adamfowleruk/herald-hardware/wearable-v2/housing/eHealthMakersKit.FCStd

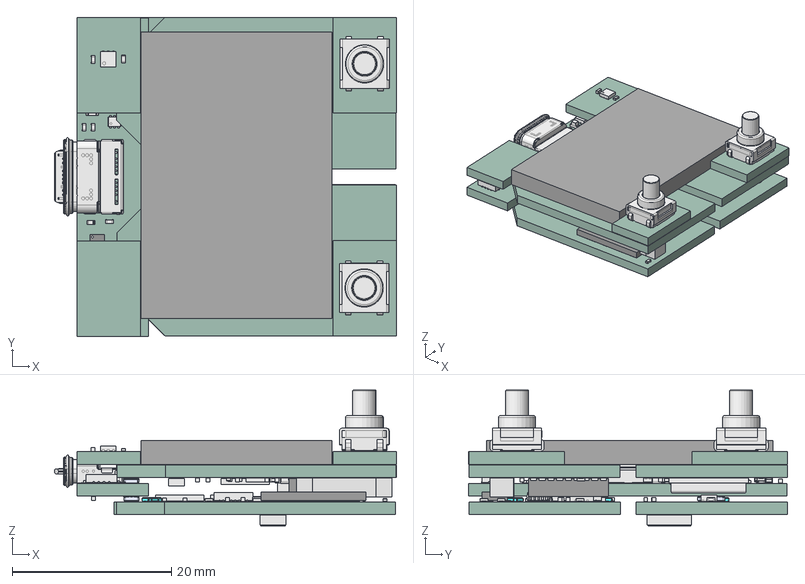
[picture p1: CAD file, 2023-11-01]
wearable-v2/housing/eHealthMakersKit.FCStd
43.0 x 40.1 x 17.1 mm
_autosave-wearable-v2 PCB3
_autosave-wearable-v2 PCB6
_autosave-wearable-v2 PCB7
_autosave-wearable-v2 PCB2
_autosave-wearable-v2 PCB4
_autosave-wearable-v2 PCB1
_autosave-wearable-v2 PCB9
_autosave-wearable-v2 PCB8
_autosave-wearable-v2 PCB5
