adamfowleruk/herald-hardware/wearable-v2/pcb-expansion-positioning/pcb-expansion-positioning.step

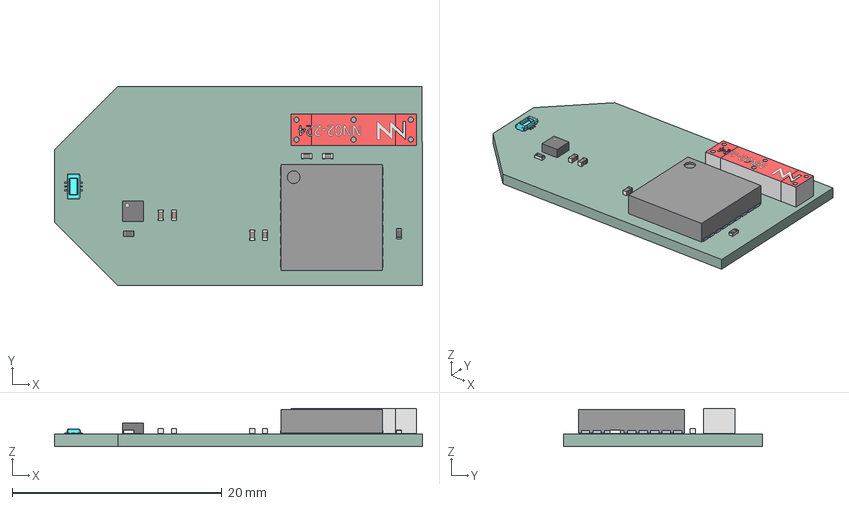
[picture p2: CAD file, 2023-11-05]
wearable-v2/pcb-expansion-positioning/pcb-expansion-positioning.step
35.1 x 19.0 x 3.64 mm
pcb-expansion-positioning PCB
