adamfowleruk/herald-hardware/wearable-v2/pcb-expansion-positioning/pcb-expansion-positioning.kicad_pcb

## KiCad design wearable-v2/pcb-expansion-positioning/pcb-expansion-positioning.kicad_pcb (2023-11-13)

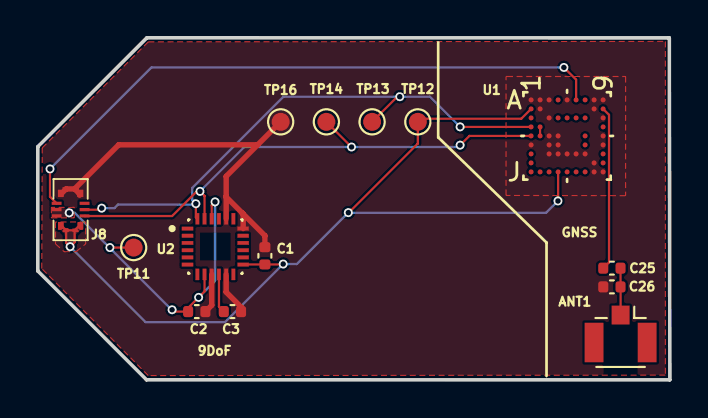
[picture p3: board pcb-expansion-positioning.kicad_pcb from above]

Board: 2 copper layers, 35.1 x 19.0 mm, 14 parts (0 on the bottom side), 10 nets.

Parts:
ANT1: U.FL_Hirose_U.FL-R-SMT-1_Vertical
C1, C2, C3: 100nF; C_0402_1005Metric
C25: 120pF; C_0402_1005Metric
C26: Tune (~120pF); C_0402_1005Metric
J8: HERALD_V2_CONN_PLUG; HERALD_V2_CONN_PORT
TP11: VDD1; TestPoint_Pad_D1.0mm
TP12: VDD; TestPoint_Pad_D1.0mm
TP13: SDA; TestPoint_Pad_D1.0mm
TP14: SCL; TestPoint_Pad_D1.0mm
TP16: GND; TestPoint_Pad_D1.0mm
U1: MIA-M10Q-00B; LGA_M10Q-00B_UBL
U2: ICM-20948; ICM-20948-QFN40P300X300X105-24N

Connections:
/Positioning Board V1/ANT_RF: C25.1, U1.B9 (RF_IN)
/Positioning Board V1/GNSS_INT: J8.6 (INT), U1.A6 (EXTINT)
/Positioning Board V1/SCL: J8.3 (SCL), TP14.1, U1.E1 (SCL), U2.23 (SCL/SCLK)
/Positioning Board V1/SDA: J8.5 (SDA), TP13.1, U1.D1 (SDA), U2.24 (SDA/SDI)
GND: C1.2, C2.1, C3.1, C26.2, J8.8 (GND), TP16.1, U1.A1 (GND), U1.A2 (GND), U1.A3 (GND), U1.A5 (RTC_O), U1.A8 (GND), U1.A9 (GND), U1.B2 (GND), U1.B8 (GND), U1.C3 (GND), U1.C9 (GND), U1.E3 (GND), U1.E4 (GND), U1.E9 (GND), U1.F1 (GND), U1.F3 (GND), U1.F4 (GND), U1.F9 (RESERVED), U1.G3 (GND), U1.G4 (GND), U1.G5 (GND), U1.G6 (GND), U1.G7 (RESERVED), U1.H8 (GND), U1.J8 (GND), U1.J9 (GND), U2.9 (AD0/SDO), U2.11 (FSYNC), U2.18 (GND), U2.20 (RESV_20)
unnamed: ANT1.1, C25.2, C26.1
unnamed: U1.D2 (RESERVED), U1.E2 (RESERVED)
unnamed: C3.2, U2.10 (REGOUT)
VDD: C1.1, J8.1 (3V3), TP12.1, U1.B1 (VCC), U1.J4 (V_IO), U2.13 (VDD)
VDD1: C2.2, J8.2 (1V8), J8.4 (1V8), TP11.1, U2.8 (VDDIO), U2.22 (~CS)
