adamfowleruk/herald-hardware/wearable-v2/pcb-connector-micro/pcb-connector-micro.kicad_pcb

## KiCad design wearable-v2/pcb-connector-micro/pcb-connector-micro.kicad_pcb (2023-11-13)

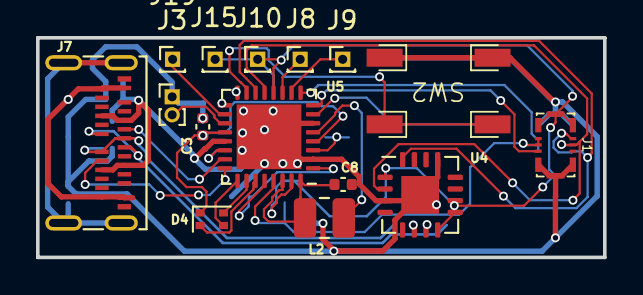
[picture p4: board pcb-connector-micro.kicad_pcb from above]

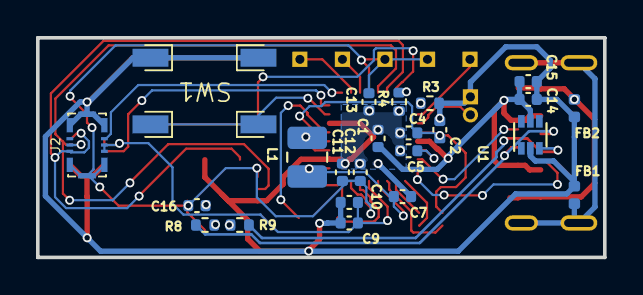
[picture p5: board pcb-connector-micro.kicad_pcb from below]

Board: 2 copper layers, 31.5 x 12.2 mm, 38 parts (23 on the bottom side), 33 nets.

Parts:
C1, C5: 1uF; C_0402_1005Metric
C2, C3, C4, C7, C8, C9, C10, C11, C12: 10uF; C_0402_1005Metric
C13, C16: 100nF; C_0402_1005Metric
C14: 4.7uF; C_0402_1005Metric
C15: 100nF/100V; C_0402_1005Metric
D4: LED_ARGY; LED_Kingbright_APHF1608
FB1, FB2: 120R/0.6A; L_0402_1005Metric
J1, J2: HERALD_V2_CONN_RECEPTACLE
J3, J8, J9, J10, J15: Conn_01x01_Pin; PinHeader_1x01_P1.00mm_Vertical
J7: USB_C_Receptacle_USB2.0; USB_C_Receptacle_IPxx
J19: Conn_01x02_Pin; PinHeader_1x02_P1.00mm_Vertical
L1, L2: 2.2uH; L_1008_2520Metric
R3: 4.7K; R_0402_1005Metric
R4: 499K; R_0402_1005Metric
R8, R9: 27; R_0402_1005Metric
SW1, SW2: PTS526
U1: DT1446-04V; SOT-563
U4: FT201XQ; QFN-16-1EP_4x4mm_P0.65mm_EP2.1x2.1mm
U5: nPM1300-QEAA; QFN-32-1EP_5x5mm_P0.5mm_EP3.6x3.6mm

Connections:
/Micro Connector/+BATT: J19.2, U5.19 (VBAT)
/Micro Connector/CC1: J7.A5 (CC1), U5.23 (CC1)
/Micro Connector/CC2: J7.B5 (CC2), U5.24 (CC2)
/Micro Connector/GPIO_1: J9.1, U5.10 (GPIO3)
/Micro Connector/GPIO_2: J8.1, U5.11 (GPIO4)
/Micro Connector/I3C_SCL: J1.3 (SCL), J2.3 (SCL), U4.16 (SCL), U5.14 (SCL)
/Micro Connector/I3C_SDA: J1.5 (SDA), J2.5 (SDA), U4.2 (SDA), U5.13 (SDA)
/Micro Connector/INT_1: J1.6 (INT), U5.8 (GPIO1)
/Micro Connector/INT_2: J2.6 (INT), U5.9 (GPIO2)
/Micro Connector/LED_PWR_G: D4.3 (GK), U5.25 (LED0)
/Micro Connector/LED_PWR_R: D4.2 (RK), U5.27 (LED2)
/Micro Connector/LED_PWR_Y: D4.4 (BK), U5.26 (LED1)
/Micro Connector/NTC: J3.1, U5.18 (NTC)
/Micro Connector/RST_CONN: SW1.1, SW1.2, U5.7 (GPIO0)
/Micro Connector/USB_D+: J7.A6 (D+), J7.B6 (D+), R9.1, U1.3
/Micro Connector/USB_D-: J7.A7 (D-), J7.B7 (D-), R8.2, U1.1
/Micro Connector/VBUSOUT: C5.1, U5.22 (VBUSOUT)
/Micro Connector/VCC_1V8: C9.1, C10.1, J1.2 (1V8), J1.4 (1V8), J2.2 (1V8), J2.4 (1V8), U5.29 (VOUTLDO1)
/Micro Connector/VOUT1: C7.1, L1.1, U5.1 (VOUT1), U5.28 (VINLDO1)
/Micro Connector/VOUT2: C8.1, L2.1, U5.30 (VINLDO2), U5.32 (VOUT2)
/Micro Connector/VSYS: C2.1, C3.1, C4.1, D4.1 (A), U5.4 (PVDD), U5.20 (VSYS)
Earth: FB1.1, J7.S1 (SHIELD)
GND: C1.2, C2.2, C3.2, C4.2, C5.2, C7.2, C8.2, C9.2, C10.2, C11.2, C12.2, C13.1, C14.1, C15.1, C16.2, FB1.2, FB2.2, J1.8 (GND), J2.8 (GND), J19.1, R3.2, R4.1, SW1.3, SW1.4, SW2.3, SW2.4, U1.2, U4.3 (GND), U4.13 (GND), U4.17 (GND), U5.2 (PVSS1), U5.6 (PVSS2), U5.33 (AVS)
GNDPWR: FB2.1, J7.A1 (GND), J7.A12 (GND), J7.B1 (GND), J7.B12 (GND)
unnamed: R8.1, U4.7 (USBDM)
unnamed: R9.2, U4.6 (USBDP)
unnamed: SW2.1, SW2.2, U5.15 (SHPHLD)
unnamed: L1.2, U5.3 (SW1)
unnamed: L2.2, U5.5 (SW2)
unnamed: R3.1, U5.17 (VSET1)
unnamed: R4.2, U5.16 (VSET2)
VBUS: C1.1, C14.2, C15.2, J7.A4 (VBUS), J7.A9 (VBUS), J7.B4 (VBUS), J7.B9 (VBUS), U1.5, U5.21 (VBUS)
VDD: C11.1, C12.1, C13.2, C16.1, J1.1 (3V3), J2.1 (3V3), J10.1, J15.1, U4.1 (VCCIO), U4.8 (3V3OUT), U4.9 (~RESET), U4.10 (VCC), U5.12 (VDDIO), U5.31 (VOUTLDO2)
