adamfowleruk/herald-hardware/wearable-v2/pcb-expansion-feedback/pcb-expansion-feedback.kicad_pcb

## KiCad design wearable-v2/pcb-expansion-feedback/pcb-expansion-feedback.kicad_pcb (2023-11-11)

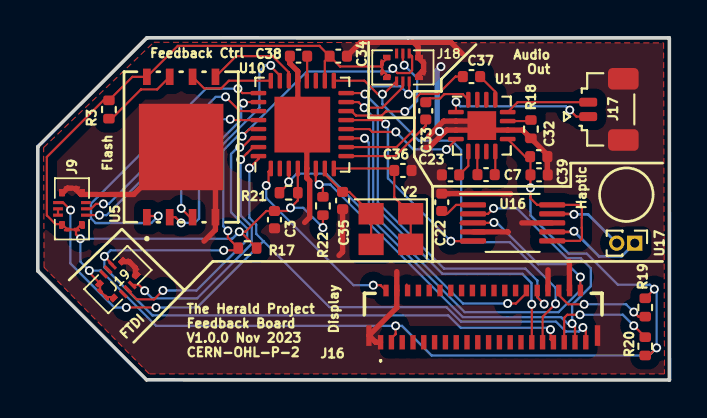
[picture p6: board pcb-expansion-feedback.kicad_pcb from above]

Board: 2 copper layers, 35.1 x 19.0 mm, 31 parts (0 on the bottom side), 43 nets.

Parts:
BoardFeedback: Board Feedback; Board
C3, C38, C39: 100nF 0402; C_0402_1005Metric
C7, C22, C23, C32: 1uF 0402; C_0402_1005Metric
C33, C37: 2.2uF 0402; C_0402_1005Metric
C34: 10uF 0402; C_0402_1005Metric
C35, C36: 22pF 0402; C_0402_1005Metric
J9, J19: HERALD_V2_CONN_PLUG; HERALD_V2_CONN_PORT
J16: EA_WF030-39S; EAWF03039S
J17: JST_AUDIO_OUT; JST_SUR_SM02B-SURS-TF_1x02-1MP_P0.80mm_Horizontal
J18: HERALD_V2_CONN_PLUG_ARMSWD; HERALD_V2_CONN_PORT
R3: 10k; R_0402_1005Metric
R17, R21, R22: 1k 0402; R_0402_1005Metric
R18: 49.9k 0402; R_0402_1005Metric
R19, R20: 10k 0402; R_0402_1005Metric
U5: MX25R6435FZNIL0; 8-WSON_MAC
U10: ATmega328PB-M; QFN-32-1EP_5x5mm_P0.5mm_EP3.1x3.1mm
U13: TPA6139A2RGTR; TQFN-16-1EP_3x3mm_P0.5mm_EP1.6x1.6mm
U16: DRV2605LDGSR; VSSOP-10_3x3mm_P0.5mm
U17: VG0832013D; PinHeader_1x02_P1.00mm_Vertical
Y2: 8Mhz; Crystal_SMD_3225-4Pin_3.2x2.5mm

Connections:
/ Display Board V1/DISP_CSX: J16.28, U10.11 (PD7)
/ Display Board V1/DISP_DCX: J16.31, J18.3 (SCL), U10.17 (PB5)
/ Display Board V1/DISP_IM1+IM2: J16.34, R19.2
/ Display Board V1/DISP_IM3: J16.35, R20.2
/ Display Board V1/DISP_SDA: J16.29, J18.5 (SDA), U10.15 (PB3)
/ Display Board V1/DISP_SDO: J16.30, J18.7 (SDO), U10.16 (PB4)
/ Display Board V1/FB_AUDIO_PWM_LEFT: C33.2, U10.9 (PD5)
/ Display Board V1/FB_AUDIO_PWM_RIGHT: C37.1, U10.10 (PD6)
/ Display Board V1/FB_AUDIO_SEL: U10.12 (PB0), U13.4 (MUTE)
/ Display Board V1/FB_AVR_RESET: J16.33, J18.6 (RST), J19.6 (INT), R17.1, U10.29 (~RESET/PC6)
/ Display Board V1/FB_FLASH_RST: R3.2, U5.7 (~RESET/SIO3)
/ Display Board V1/FB_FLASH_SEL: U5.1 (~CS), U10.25 (PC2)
/ Display Board V1/FB_FLASH_WP: U5.3 (~WP/SIO2), U10.26 (PC3)
/ Display Board V1/FB_INT: J9.6 (INT), J16.39, U10.32 (PD2)
/ Display Board V1/FB_LED_PWM: J16.2, U10.1 (PD3)
/ Display Board V1/FB_LRA+: U16.7 (OUT+), U17.1 (LRA+)
/ Display Board V1/FB_LRA-: U16.9 (OUT-), U17.2 (LRA-)
/ Display Board V1/FB_MISO1: U5.2 (SO/SIO1), U10.23 (PC0)
/ Display Board V1/FB_MOSI1: U5.5 (SI/SIO0), U10.22 (PE3)
/ Display Board V1/FB_SCK1: U5.6 (SCLK), U10.24 (PC1)
/ Display Board V1/FB_SCL: J16.37, R22.2, U10.6 (PE1), U16.2 (SCL)
/ Display Board V1/FB_SDA: J16.38, R21.2, U10.3 (PE0), U16.3 (SDA)
/ Display Board V1/FB_SPEAKER_OUT_LEFT: J17.1, U13.1 (OUT_L)
/ Display Board V1/FB_SPEAKER_OUT_RIGHT: J17.2, U13.12 (OUT_R)
/ Display Board V1/FB_SS0: J18.4 (SEL), U10.14 (PB2)
/ Display Board V1/FB_TWI_RX: J19.5 (SDA), U10.30 (PD0)
/ Display Board V1/FB_TWI_TX: J19.7 (GPIO), U10.31 (PD1)
/ Display Board V1/FB_VIBRATE_EN: U10.13 (PB1), U16.5 (EN)
/ Display Board V1/I3C_SCL: J9.3 (SCL), U10.28 (PC5)
/ Display Board V1/I3C_SDA: J9.5 (SDA), U10.27 (PC4)
/ Display Board V1/VCC_1V8: J9.2 (1V8), J9.4 (1V8)
GND: C3.1, C22.1, C23.2, C32.2, C34.2, C35.1, C36.1, C38.1, C39.2, J9.8 (GND), J16.1, J16.4, J16.32, J16.36, J16.MP1, J16.MP2, J17.MP, J18.8 (GND), J19.8 (GND), R18.2, U5.4 (GND), U5.9, U10.5 (GND), U10.21 (GND), U10.33 (GND), U13.2 (GND), U13.3 (GND), U13.10 (GND), U13.17 (GND), U16.4 (IN/TRIG), U16.8 (GND)
unnamed: C38.2, U10.20 (AREF)
unnamed: C35.2, U10.7 (XTAL1/PB6), Y2.2, Y2.3
unnamed: C36.2, U10.8 (XTAL2/PB7), Y2.1, Y2.4
unnamed: C7.2, U13.6 (CN)
unnamed: C7.1, U13.8 (CP)
unnamed: R18.1, U13.11 (GAIN)
unnamed: C33.1, U13.16 (IN_L)
unnamed: C37.2, U13.13 (IN_R)
unnamed: C23.1, U13.5 (VSS)
unnamed: C22.2, U16.1 (REG)
VDD: C3.2, C32.1, C34.1, C39.1, J9.1 (3V3), J16.3, J18.1 (3V3), J19.1 (3V3), R3.1, R17.2, R19.1, R20.1, R21.1, R22.1, U5.8 (VCC), U10.4 (VCC), U10.18 (AVCC), U13.9 (VDD), U16.6 (VDD/NC), U16.10 (VDD)
