adamfowleruk/herald-hardware/wearable-v2/pcb-connector-standard/pcb-standard-connector.kicad_pcb

## KiCad design wearable-v2/pcb-connector-standard/pcb-standard-connector.kicad_pcb (2023-11-11)

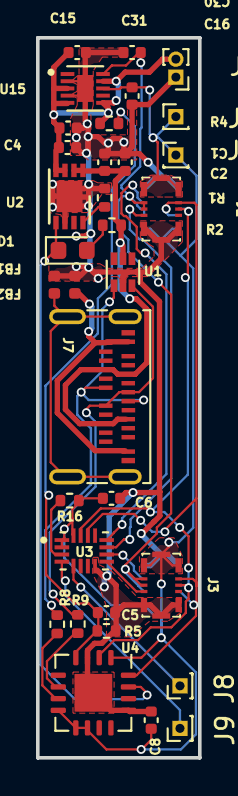
[picture p7: board pcb-standard-connector.kicad_pcb from above]

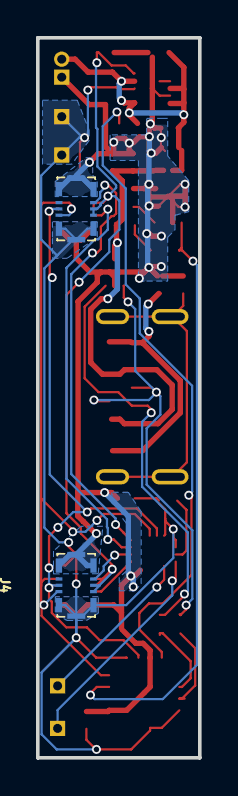
[picture p8: board pcb-standard-connector.kicad_pcb from below]

Board: 2 copper layers, 9.0 x 40.0 mm, 35 parts (2 on the bottom side), 24 nets.

Parts:
C1, C4, C6: 4.7uF; C_0402_1005Metric
C2: 100nF/100V; C_0402_1005Metric
C5: 10nF; C_0402_1005Metric
C8: 100nF; C_0402_1005Metric
C15, C16, C30, C31: 1uF; C_0402_1005Metric
D1: CHSTAT; LED_0603_1608Metric
FB1, FB2: 120R/0.6A; L_0402_1005Metric
J1, J2, J3, J4: HERALD_V2_CONN_RECEPTACLE
J7: USB_C_Receptacle_USB2.0; USB_C_Receptacle_IPxx
J8, J9, J10, J15: Conn_01x01_Pin; PinHeader_1x01_P1.00mm_Vertical
J18: Conn_01x02_Pin; PinHeader_1x02_P1.00mm_Vertical
R1, R16: 10k; R_0402_1005Metric
R2: 5.6k; R_0402_1005Metric
R4: 6.8M; R_0402_1005Metric
R5: 10M; R_0402_1005Metric
R8, R9: 27; R_0402_1005Metric
U1: DT1446-04V; SOT-563
U2: MCP73831/2-2MC; DFN-8-1EP_3x2mm_P0.5mm_EP1.75x1.45mm
U3: TCA6408A; QFN40P180X260X55-16N
U4: FT201XQ; QFN-16-1EP_4x4mm_P0.65mm_EP2.1x2.1mm
U15: TLV751; SON40P200X200X80-11N

Connections:
+1V8: C31.2, J1.2 (1V8), J1.4 (1V8), J2.2 (1V8), J2.4 (1V8), J3.2 (1V8), J3.4 (1V8), J4.2 (1V8), J4.4 (1V8), U15.10 (OUT1)
+BATT: C4.2, C15.2, C16.2, J18.2, R4.1, U2.3 (VBAT), U2.4 (VBAT), U15.3 (EN1), U15.5 (EN2), U15.6 (IN2), U15.9 (IN1)
/Standard Connector/BT_STAT: C5.1, R4.2, R5.1, U4.4 (CBUS4)
/Standard Connector/CH_STAT: D1.1 (K), U2.5 (STAT), U4.15 (CBUS5)
/Standard Connector/GPIO_1: J9.1, U3.4 (P0)
/Standard Connector/GPIO_2: J8.1, U3.5 (P1)
/Standard Connector/I3C_SCL: J1.3 (SCL), J2.3 (SCL), J3.3 (SCL), J4.3 (SCL), U3.14 (SCL), U4.16 (SCL)
/Standard Connector/I3C_SDA: J1.5 (SDA), J2.5 (SDA), J3.5 (SDA), J4.5 (SDA), U3.15 (SDA), U4.2 (SDA)
/Standard Connector/INT_1: J1.6 (INT), U3.11 (P6)
/Standard Connector/INT_2: J2.6 (INT), U3.12 (P7)
/Standard Connector/INT_3: J3.6 (INT), U3.9 (P4)
/Standard Connector/INT_4: J4.6 (INT), U3.10 (P5)
/Standard Connector/RST_CONN: R16.2, U3.3 (RST)
/Standard Connector/USB_D+: J7.A6 (D+), J7.B6 (D+), R9.1, U1.3
/Standard Connector/USB_D-: J7.A7 (D-), J7.B7 (D-), R8.2, U1.1
Earth: FB1.1, J7.S1 (SHIELD)
GND: C1.1, C2.1, C4.1, C5.2, C6.2, C8.2, C15.1, C16.1, C30.1, C31.1, FB1.2, FB2.2, J1.8 (GND), J2.8 (GND), J3.8 (GND), J4.8 (GND), J18.1, R1.1, R5.2, U1.2, U2.6 (VSS), U2.9, U3.8 (GND), U4.3 (GND), U4.13 (GND), U4.17 (GND), U15.2 (GND), U15.4 (GND), U15.11
GNDPWR: FB2.1, J7.A1 (GND), J7.A12 (GND), J7.B1 (GND), J7.B12 (GND)
unnamed: D1.2 (A), R2.1
unnamed: R1.2, U2.8 (PROG)
unnamed: R8.1, U4.7 (USBDM)
unnamed: R9.2, U4.6 (USBDP)
VBUS: C1.2, C2.2, J7.A4 (VBUS), J7.A9 (VBUS), J7.B4 (VBUS), J7.B9 (VBUS), R2.2, U1.5, U2.1 (VDD), U2.2 (VDD)
VDD: C6.1, C8.1, C30.2, J1.1 (3V3), J2.1 (3V3), J3.1 (3V3), J4.1 (3V3), J10.1, J15.1, R16.1, U3.1 (VCCI), U3.2 (ADDR), U3.16 (VCCP), U4.1 (VCCIO), U4.8 (3V3OUT), U4.9 (~RESET), U4.10 (VCC), U15.8 (OUT2)
