adamfowleruk/herald-hardware/wearable-v2/pcb-compute-nrf52833-bc833m/pcb-compute-nrf52833-bc833m.kicad_pcb

## KiCad design wearable-v2/pcb-compute-nrf52833-bc833m/pcb-compute-nrf52833-bc833m.kicad_pcb (2023-11-11)

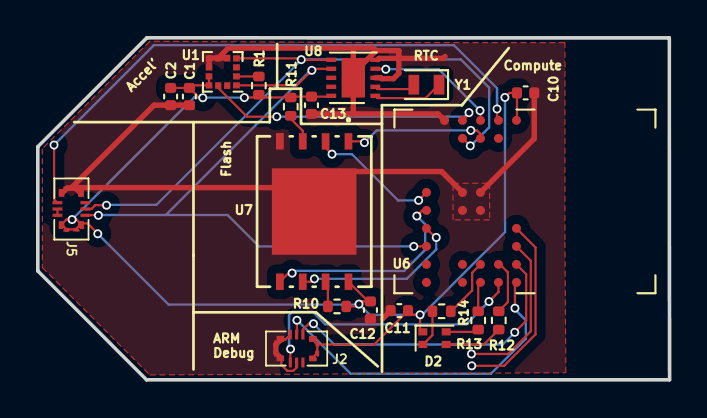
[picture p9: board pcb-compute-nrf52833-bc833m.kicad_pcb from above]

Board: 2 copper layers, 35.1 x 19.0 mm, 21 parts (0 on the bottom side), 26 nets.

Parts:
C1, C11: 10uF; C_0402_1005Metric
C2, C12, C13: 100nF; C_0402_1005Metric
C10: 4.7uF; C_0402_1005Metric
ComputeBC833M: Board Compute BC833M; Board
D2: LED_ARBG; LED_Kingbright_APHF1608
J2: HERALD_V2_CONN_PLUG_ARMSWD; HERALD_V2_CONN_PORT
J5: HERALD_V2_CONN_PLUG; HERALD_V2_CONN_PORT
R1, R10, R11: 10k; R_0402_1005Metric
R12: 0; R_0402_1005Metric
R13: 3.9k; R_0402_1005Metric
R14: 1k; R_0402_1005Metric
U1: LIS2DE12; LGA-12_2x2mm_P0.5mm
U6: BC833; Fanstel_BC833x
U7: MX25R6435F; 8-WSON_MAC
U8: PCF85063ATL; DFN-10-1EP_2.6x2.6mm_P0.5mm_EP1.25x2.15mm
Y1: 32.768kHz; Crystal_SMD_2012-2Pin_2.0x1.2mm

Connections:
/Compute BC833M/ACC_INT2: U1.11 (INT2), U6.4 (P0.28/AIN4)
/Compute BC833M/EXT_INT1: J5.6 (INT), U6.2 (P0.03/AIN1)
/Compute BC833M/FLASH_CS: U6.7 (P0.30/AIN6), U7.1 (~CS)
/Compute BC833M/FLASH_RST: R10.2, U7.7 (~RESET/SIO3)
/Compute BC833M/FLASH_WP: R11.2, U7.3 (~WP/SIO2)
/Compute BC833M/LED_B: R12.1, U6.21 (P0.20)
/Compute BC833M/LED_G: R13.1, U6.16 (P0.15)
/Compute BC833M/LED_R: R14.1, U6.20 (P0.17)
/Compute BC833M/MISO: U6.9 (P0.04/AIN2), U7.2 (SO/SIO1)
/Compute BC833M/MOSI: U6.10 (P0.05/AIN3), U7.5 (SI/SIO0)
/Compute BC833M/RESETn: J2.6 (RST), U6.17 (~RESET/P0.18)
/Compute BC833M/RTC_INT: U6.3 (P0.02/AIN0), U8.4 (~INT)
/Compute BC833M/SCL: J5.3 (SCL), U1.1 (SCL/SPC), U6.12 (P0.11), U8.7 (SCL)
/Compute BC833M/SCLK: U6.11 (P1.09), U7.6 (SCLK)
/Compute BC833M/SDA: J5.5 (SDA), U1.4 (SDA/SDI), U6.8 (P0.31/AIN7), U8.6 (SDA)
/Compute BC833M/SWDCLK: J2.3 (SCL), U6.22 (SWDCLK)
/Compute BC833M/SWDIO: J2.5 (SDA), U6.18 (SWDIO)
/Compute BC833M/VCC_1V8: J5.2 (1V8), J5.4 (1V8)
GND: C1.2, C2.2, C10.2, C11.2, C12.1, C13.2, J2.4 (SEL), J2.7 (SDO), J2.8 (GND), J5.8 (GND), U1.5 (RES), U1.6 (GND), U1.7 (GND), U1.8 (GND), U6.5 (GND), U6.25 (GND), U6.26 (GND), U6.27 (GND), U6.28 (GND), U7.4 (GND), U7.9, U8.3 (CLKOE), U8.5 (VSS), U8.EP
unnamed: D2.3 (BK), R12.2
unnamed: D2.4 (GK), R13.2
unnamed: D2.2 (RK), R14.2
unnamed: R1.2, U1.2 (~CS)
unnamed: U8.1 (OSCI), Y1.1
unnamed: U8.2 (OSCO), Y1.2
VDD: C1.1, C2.1, C10.1, C11.1, C12.2, C13.1, D2.1 (A), J2.1 (3V3), J5.1 (3V3), R1.1, R10.1, R11.1, U1.9 (Vdd), U1.10 (Vdd_IO), U6.1 (VDD), U7.8 (VCC), U8.10 (VDD)
