adamfowleruk/herald-hardware/wearable-v2/pcb-expansion-bio/pcb-expansion-bio.kicad_pcb

## KiCad design wearable-v2/pcb-expansion-bio/pcb-expansion-bio.kicad_pcb (2023-11-05)

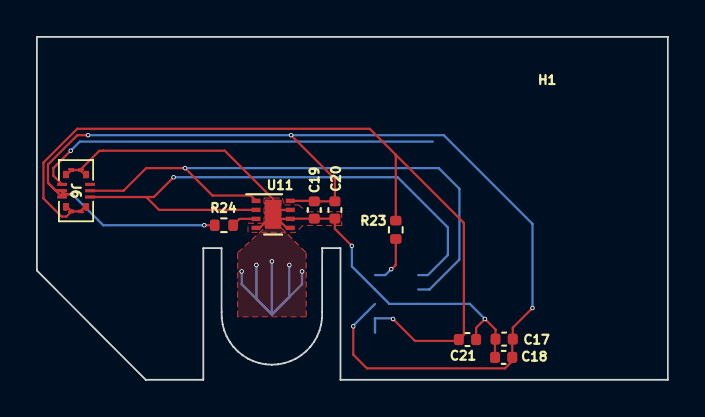
[picture p10: board pcb-expansion-bio.kicad_pcb from above]

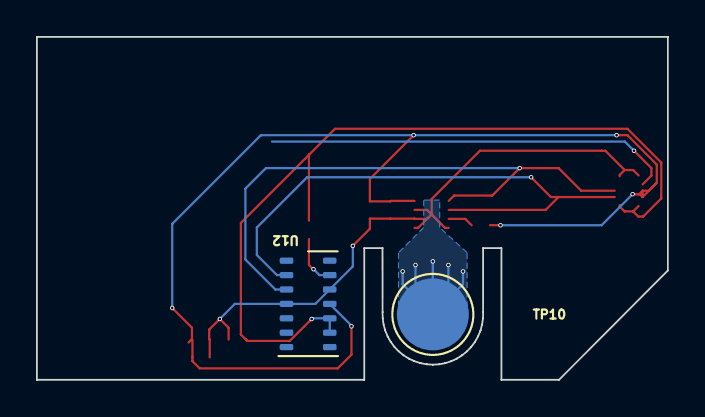
[picture p11: board pcb-expansion-bio.kicad_pcb from below]

Board: 2 copper layers, 35.1 x 19.0 mm, 13 parts (2 on the bottom side), 7 nets.

Parts:
BoardBio: Board Bio; Board
C17, C21: 10uF; C_0402_1005Metric
C18, C19: 100nF; C_0402_1005Metric
C20: 4.7uF; C_0402_1005Metric
H1: ThermalSlot; MillSlot_8.0x1.0mm
J6: HERALD_V2_CONN_PLUG; HERALD_V2_CONN_PORT
R23, R24: 1k 0402; R_0402_1005Metric
TP10: ThPad; TestPoint_Pad_D4.0mm
U11: TMP1075; WSON-8-1EP_2x2mm_P0.5mm_EP0.9x1.6mm
U12: MAX30102; Maxim_OLGA-14_3.3x5.6mm_P0.8mm

Connections:
+1V8: C17.1, C18.1, C19.2, C20.2, J6.2 (1V8), J6.4 (1V8), R24.1, U11.8 (+Vs), U12.11 (VDD)
/Bio Board V1/BIO_INT: R23.2, U12.13 (~INT)
/Bio Board V1/SCL: J6.3 (SCL), U11.2 (SCL), U12.2 (SCL)
/Bio Board V1/SDA: J6.5 (SDA), U11.1 (SDA), U12.3 (SDA)
/Bio Board V1/TMP_INT: R24.2, U11.3 (ALRT)
GND: C17.2, C18.2, C19.1, C20.1, C21.2, J6.8 (GND), TP10.1, U11.4 (GND), U11.5 (A2), U11.6 (A1), U11.7 (A0), U11.9 (EP), U12.4 (PGND), U12.12 (GND)
Vdrive: C21.1, J6.1 (3V3), R23.1, U12.9 (VLED+), U12.10 (VLED+)
