adamfowleruk/herald-hardware/wearable/pcb/wearable.kicad_pcb

## KiCad design wearable/pcb/wearable.kicad_pcb (2023-07-16, an earlier design)

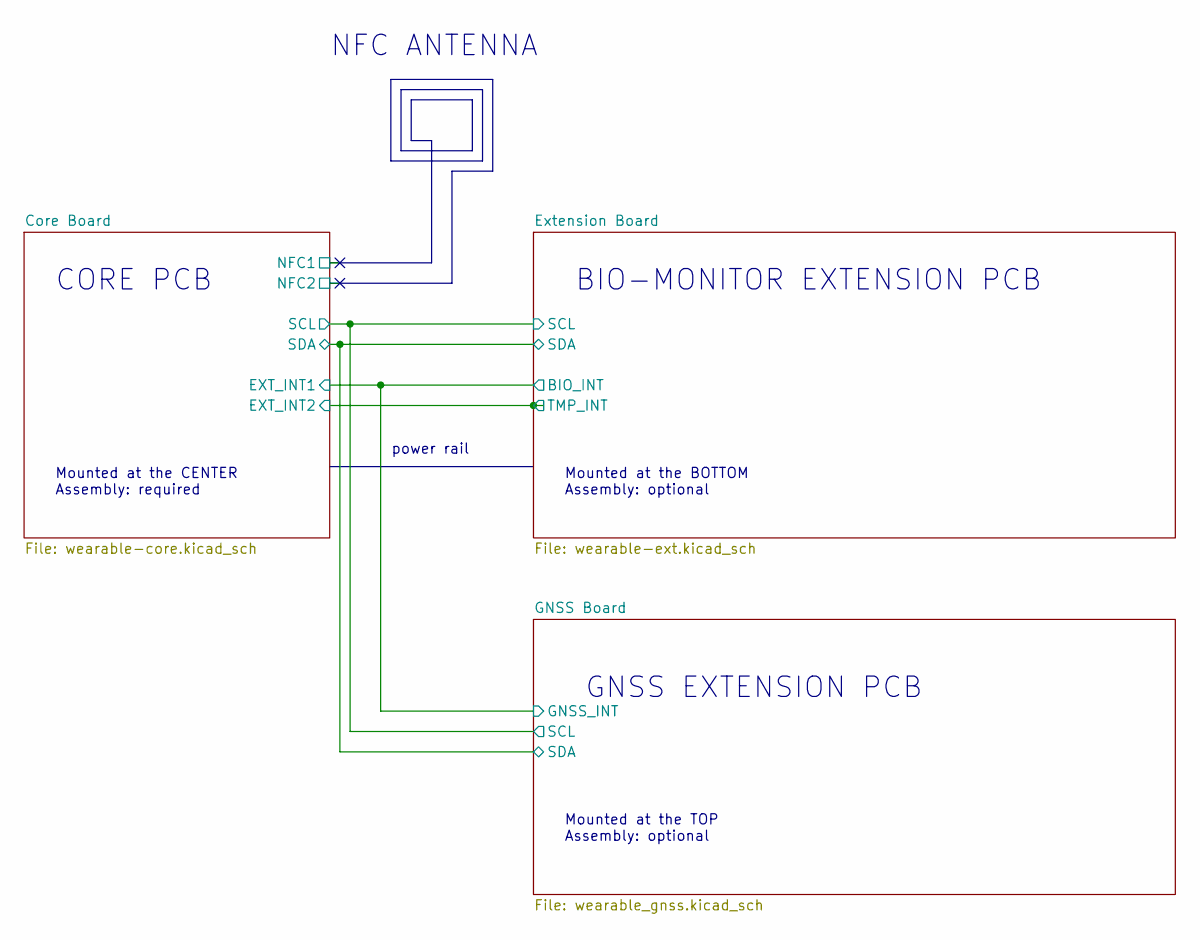
[picture p12: schematic wearable.kicad_sch, Herald Bluetooth Wearable Beacon]

Notes on the sheet:
NFC ANTENNA
Mounted at the CENTER Assembly: required
Mounted at the BOTTOM Assembly: optional
CORE PCB
GNSS EXTENSION PCB
power rail
Mounted at the TOP Assembly: optional
BIO-MONITOR EXTENSION PCB

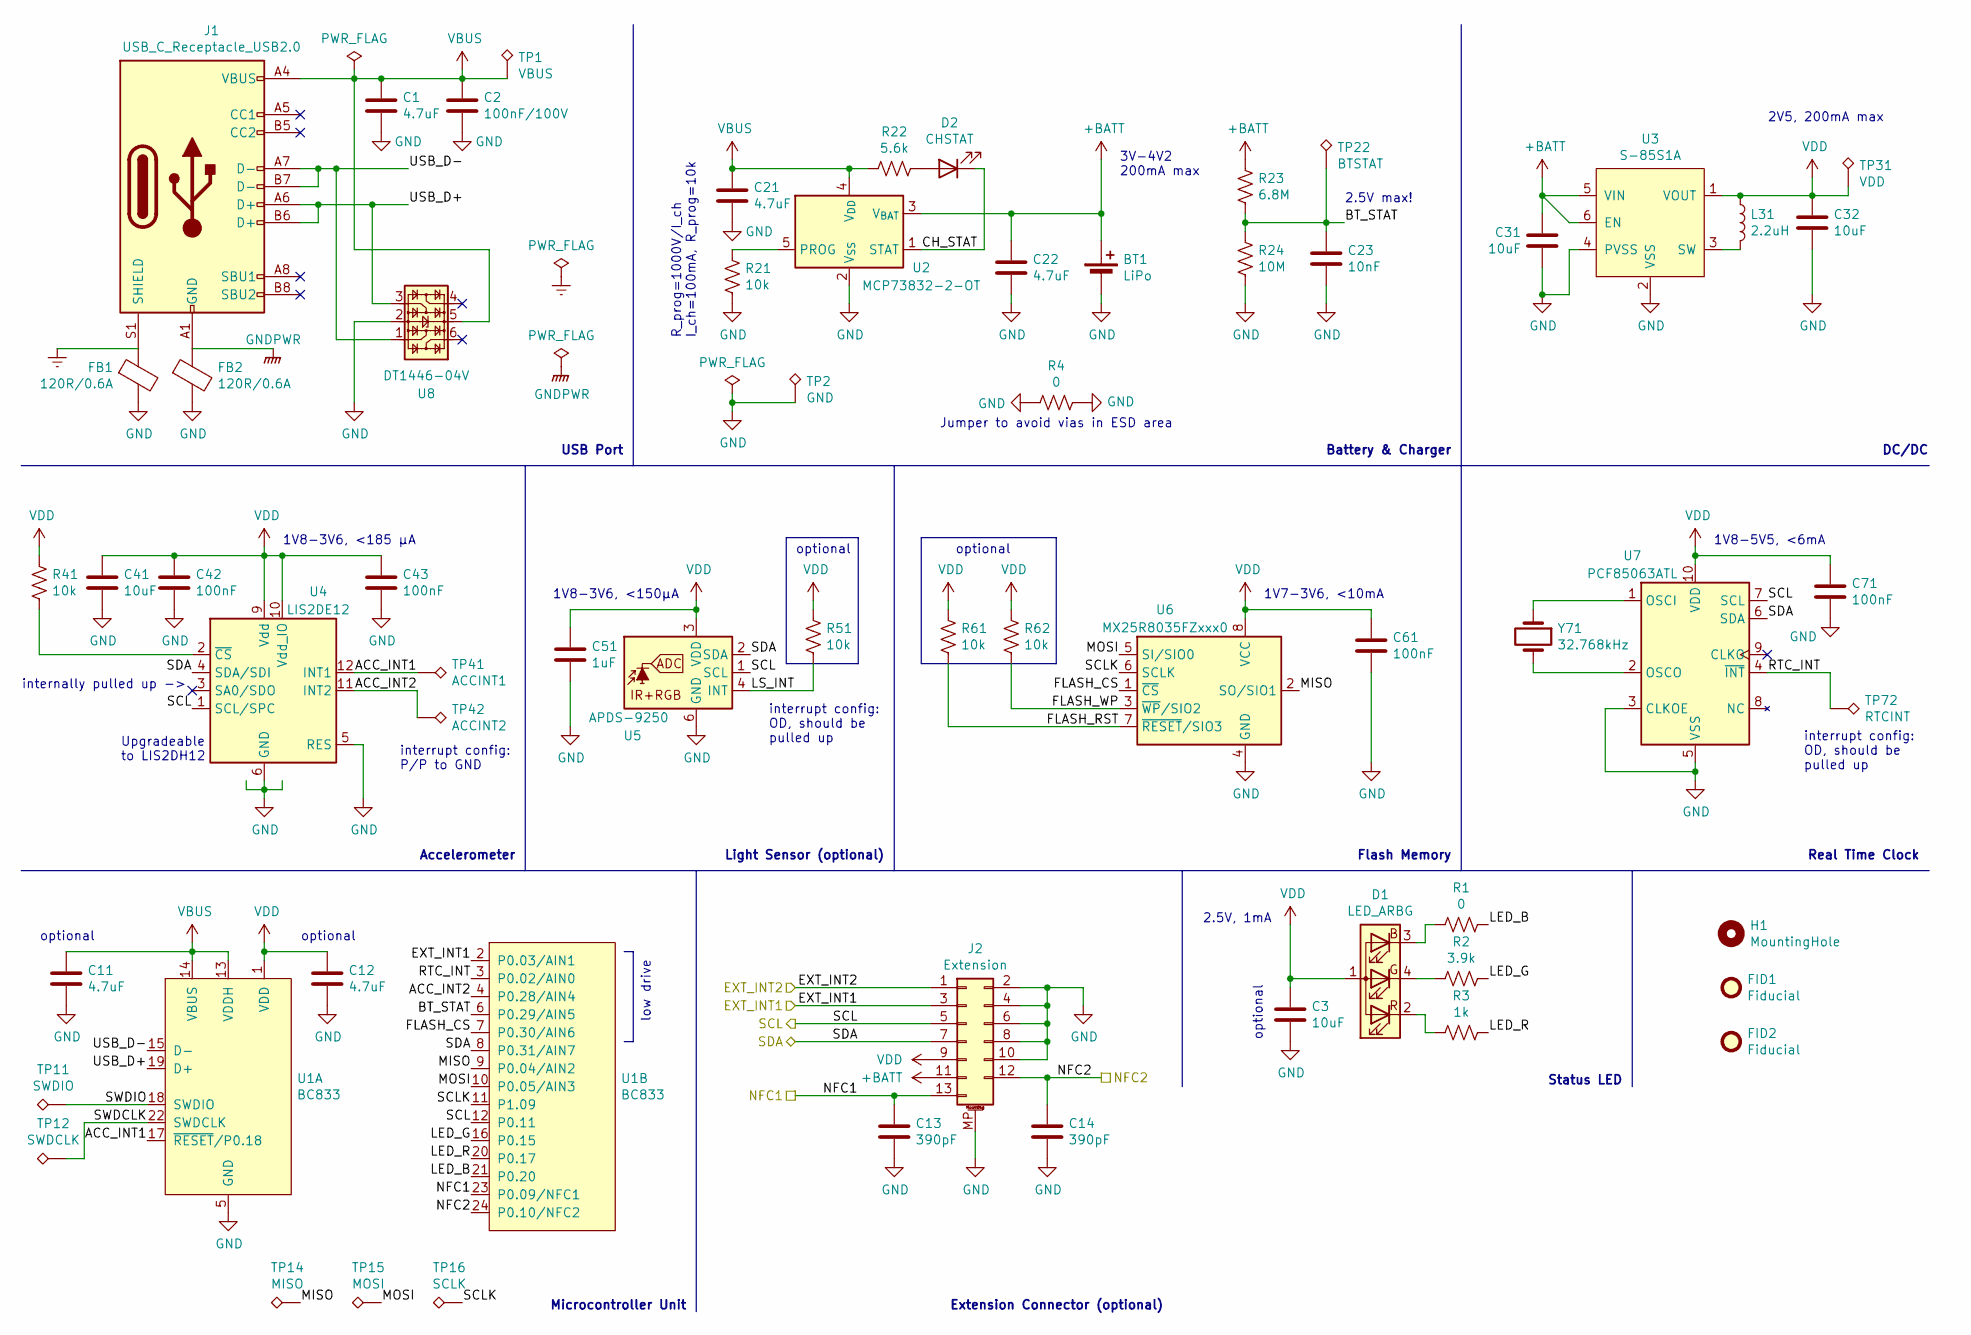
[picture p13: schematic wearable-core.kicad_sch, Herald Bluetooth Wearable Beacon]

Parts:
BT1: LiPo; Herald_Battery_Solder_Pads; MPN LI401225
C1, C11, C12, C21, C22: 4.7uF; C_0402_1005Metric; MPN 0402YD475MAT2A
C2: 100nF/100V; C_0402_1005Metric; MPN GRM155R62A104ME14D
C3, C31, C32, C41: 10uF; C_0402_1005Metric; MPN GRM155R60J106ME15D
C13, C14: 390pF; C_0402_1005Metric; MPN GCM1555C1H391FA16D
C23: 10nF; C_0402_1005Metric; MPN C0402C103K4RAC7411
C42, C43, C61, C71: 100nF; C_0402_1005Metric; MPN GRM155R71E104KE14D
C51: 1uF; C_0402_1005Metric; MPN GRM155R61C105KA12D
D1: LED_ARBG; LED_Kingbright_APHF1608; MPN APHF1608LSEEQBDZGKC
D2: CHSTAT; LED_0603_1608Metric; MPN KO DELLS1.22-KHLI-24
FB1, FB2: 120R/0.6A; L_0402_1005Metric; MPN MFBM1V1005-121-R
FID1, FID2: Fiducial; Fiducial_0.75mm_Mask1.5mm
H1: MountingHole; MountingHole_2mm
J1: USB_C_Receptacle_USB2.0; USB_C_Receptacle_IPxx; MPN 124018802112A
J2: Extension; TE_1-2328724-3_2Rows_13Pins_P0.3mm_Horizontal; MPN 1-2328724-3
L31: 2.2uH; L_0603_1608Metric; MPN MBKK1608T2R2M
R1: 0; R_0402_1005Metric; MPN RC0402FR-070RL
R2: 3.9k; R_0402_1005Metric; MPN RC0402FR-073K9L
R3: 1k; R_0402_1005Metric; MPN RC0402FR-071KL
R4: 0; R_0603_1608Metric; MPN CRCW06030000Z0EAC
R21, R41, R51, R61, R62: 10k; R_0402_1005Metric; MPN CRCW040210K0FKEDC
R22: 5.6k; R_0402_1005Metric; MPN RC0402FR-075R6L
R23: 6.8M; R_0402_1005Metric; MPN RK73H1ETTP6804F
R24: 10M; R_0402_1005Metric; MPN RK73H1ETTP1005F
TP1: VBUS; TestPoint_Pad_D1.0mm
TP2: GND; TestPoint_Pad_D1.0mm
TP11: SWDIO; TestPoint_Pad_D1.0mm
TP12: SWDCLK; TestPoint_Pad_D1.0mm
TP14: MISO; TestPoint_Pad_D1.0mm
TP15: MOSI; TestPoint_Pad_D1.0mm
TP16: SCLK; TestPoint_Pad_D1.0mm
TP22: BTSTAT; TestPoint_Pad_D1.0mm
TP31: VDD; TestPoint_Pad_D1.0mm
TP41: ACCINT1; TestPoint_Pad_D1.0mm
TP42: ACCINT2; TestPoint_Pad_D1.0mm
TP72: RTCINT; TestPoint_Pad_D1.0mm
U1: BC833; Fanstel_BC833x; MPN BC833M
U2: MCP73832-2-OT; SOT-23-5; MPN MCP73832T-2ACI/OT
U3: S-85S1A; SNT-6A; MPN S-85S1AB25-I6T1U
U4: LIS2DE12; LGA-12_2x2mm_P0.5mm; MPN LIS2DE12TR
U5: APDS-9250; Broadcom_DFN-6_2x2mm_P0.65mm; MPN APDS-9250
U6: MX25R8035FZxxx0; USON-8-1EP_2x3mm_P0.5mm_EP0.25x1.65mm; MPN MX25R8035FZUIL0
U7: PCF85063ATL; DFN-10-1EP_2.6x2.6mm_P0.5mm_EP1.25x2.15mm; MPN PCF85063ATL/1,118
U8: DT1446-04V; SOT-563; MPN DT1446-04V-7
Y71: 32.768kHz; Crystal_SMD_2012-2Pin_2.0x1.2mm; MPN RT2012-32.768-7-TR

Connections:
+BATT: BT1.1 (+), C22.2, C31.1, J2.11, R23.1, U2.3 (V_{BAT}), U3.5 (VIN), U3.6 (EN)
/Core Board/ACC_INT1: TP41.1, U1.17 (~RESET/P0.18), U4.12 (INT1)
/Core Board/ACC_INT2: TP42.1, U1.4 (P0.28/AIN4), U4.11 (INT2)
/Core Board/BT_STAT: C23.1, R23.2, R24.1, TP22.1, U1.6 (P0.29/AIN5)
/Core Board/CH_STAT: D2.1 (K), U2.1 (STAT)
/Core Board/EXT_INT1: J2.3, U1.2 (P0.03/AIN1); also elsewhere on the board
/Core Board/EXT_INT2: J2.1; also elsewhere on the board
/Core Board/FLASH_CS: U1.7 (P0.30/AIN6), U6.1 (~CS)
/Core Board/FLASH_RST: R61.2, U6.7 (~RESET/SIO3)
/Core Board/FLASH_WP: R62.2, U6.3 (~WP/SIO2)
/Core Board/LED_B: R1.1, U1.21 (P0.20)
/Core Board/LED_G: R2.1, U1.16 (P0.15)
/Core Board/LED_R: R3.1, U1.20 (P0.17)
/Core Board/LS_INT: R51.2, U5.4 (INT)
/Core Board/MISO: TP14.1, U1.9 (P0.04/AIN2), U6.2 (SO/SIO1)
/Core Board/MOSI: TP15.1, U1.10 (P0.05/AIN3), U6.5 (SI/SIO0)
/Core Board/NFC1: C13.1, J2.13, U1.23 (P0.09/NFC1)
/Core Board/NFC2: C14.1, J2.12, U1.24 (P0.10/NFC2)
/Core Board/RTC_INT: TP72.1, U1.3 (P0.02/AIN0), U7.4 (~INT)
/Core Board/SCL: J2.5, U1.12 (P0.11), U4.1 (SCL/SPC), U5.1 (SCL), U7.7 (SCL); also elsewhere on the board
/Core Board/SCLK: TP16.1, U1.11 (P1.09), U6.6 (SCLK)
/Core Board/SDA: J2.7, U1.8 (P0.31/AIN7), U4.4 (SDA/SDI), U5.2 (SDA), U7.6 (SDA); also elsewhere on the board
/Core Board/SWDCLK: TP12.1, U1.22 (SWDCLK)
/Core Board/SWDIO: TP11.1, U1.18 (SWDIO)
/Core Board/USB_D+: J1.A6 (D+), J1.B6 (D+), U1.19 (D+), U8.3
/Core Board/USB_D-: J1.A7 (D-), J1.B7 (D-), U1.15 (D-), U8.1
Earth: FB1.1, J1.S1 (SHIELD)
GND: BT1.2 (-), C1.1, C2.1, C3.2, C11.2, C12.2, C13.2, C14.2, C21.1, C22.1, C23.2, C31.2, C32.2, C41.2, C42.2, C43.2, C51.2, C61.1, C71.2, FB1.2, FB2.2, J2.2, J2.4, J2.6, J2.8, J2.10, J2.MP (MountPin), R4.1, R4.2, R21.2, R24.2, TP2.1, U1.5 (GND), U1.25 (GND), U1.26 (GND), U1.27 (GND), U1.28 (GND), U2.2 (V_{SS}), U3.2 (VSS), U3.4 (PVSS), U4.5 (RES), U4.6 (GND), U4.7 (GND), U4.8 (GND), U5.6 (GND), U6.4 (GND), U6.EP (GND), U7.3 (CLKOE), U7.5 (VSS), U8.2
GNDPWR: FB2.1, J1.A1 (GND), J1.A12 (GND), J1.B1 (GND), J1.B12 (GND)
unnamed: D1.3 (BK), R1.2
unnamed: D1.4 (GK), R2.2
unnamed: D1.2 (RK), R3.2
unnamed: D2.2 (A), R22.1
unnamed: R21.1, U2.5 (PROG)
unnamed: L31.2, U3.3 (SW)
unnamed: R41.2, U4.2 (~CS)
unnamed: U7.1 (OSCI), Y71.1
unnamed: U7.2 (OSCO), Y71.2
VBUS: C1.2, C2.2, C11.1, C21.2, J1.A4 (VBUS), J1.A9 (VBUS), J1.B4 (VBUS), J1.B9 (VBUS), R22.2, TP1.1, U1.13 (VDDH), U1.14 (VBUS), U2.4 (V_{DD}), U8.5
VDD: C3.1, C12.1, C32.1, C41.1, C42.1, C43.1, C51.1, C61.2, C71.1, D1.1 (A), J2.9, L31.1, R41.1, R51.1, R61.1, R62.1, TP31.1, U1.1 (VDD), U3.1 (VOUT), U4.9 (Vdd), U4.10 (Vdd_IO), U5.3 (VDD), U6.8 (VCC), U7.10 (VDD)

Notes on the sheet:
Microcontroller Unit
2.5V, 1mA
internally pulled up ->
Upgradeable to LIS2DH12
interrupt config: OD, should be pulled up
DC/DC
Accelerometer
low drive
interrupt config: P/P to GND
optional
Real Time Clock
1V8-3V6, <185 µA
Jumper to avoid vias in ESD area
USB Port
1V8-3V6, <150µA
Light Sensor (optional)
R_prog=1000V/I_ch I_ch=100mA, R_prog=10k
2.5V max!
Flash Memory
3V-4V2 200mA max
1V7-3V6, <10mA
Status LED
2V5, 200mA max
Extension Connector (optional)
1V8-5V5, <6mA
Battery & Charger

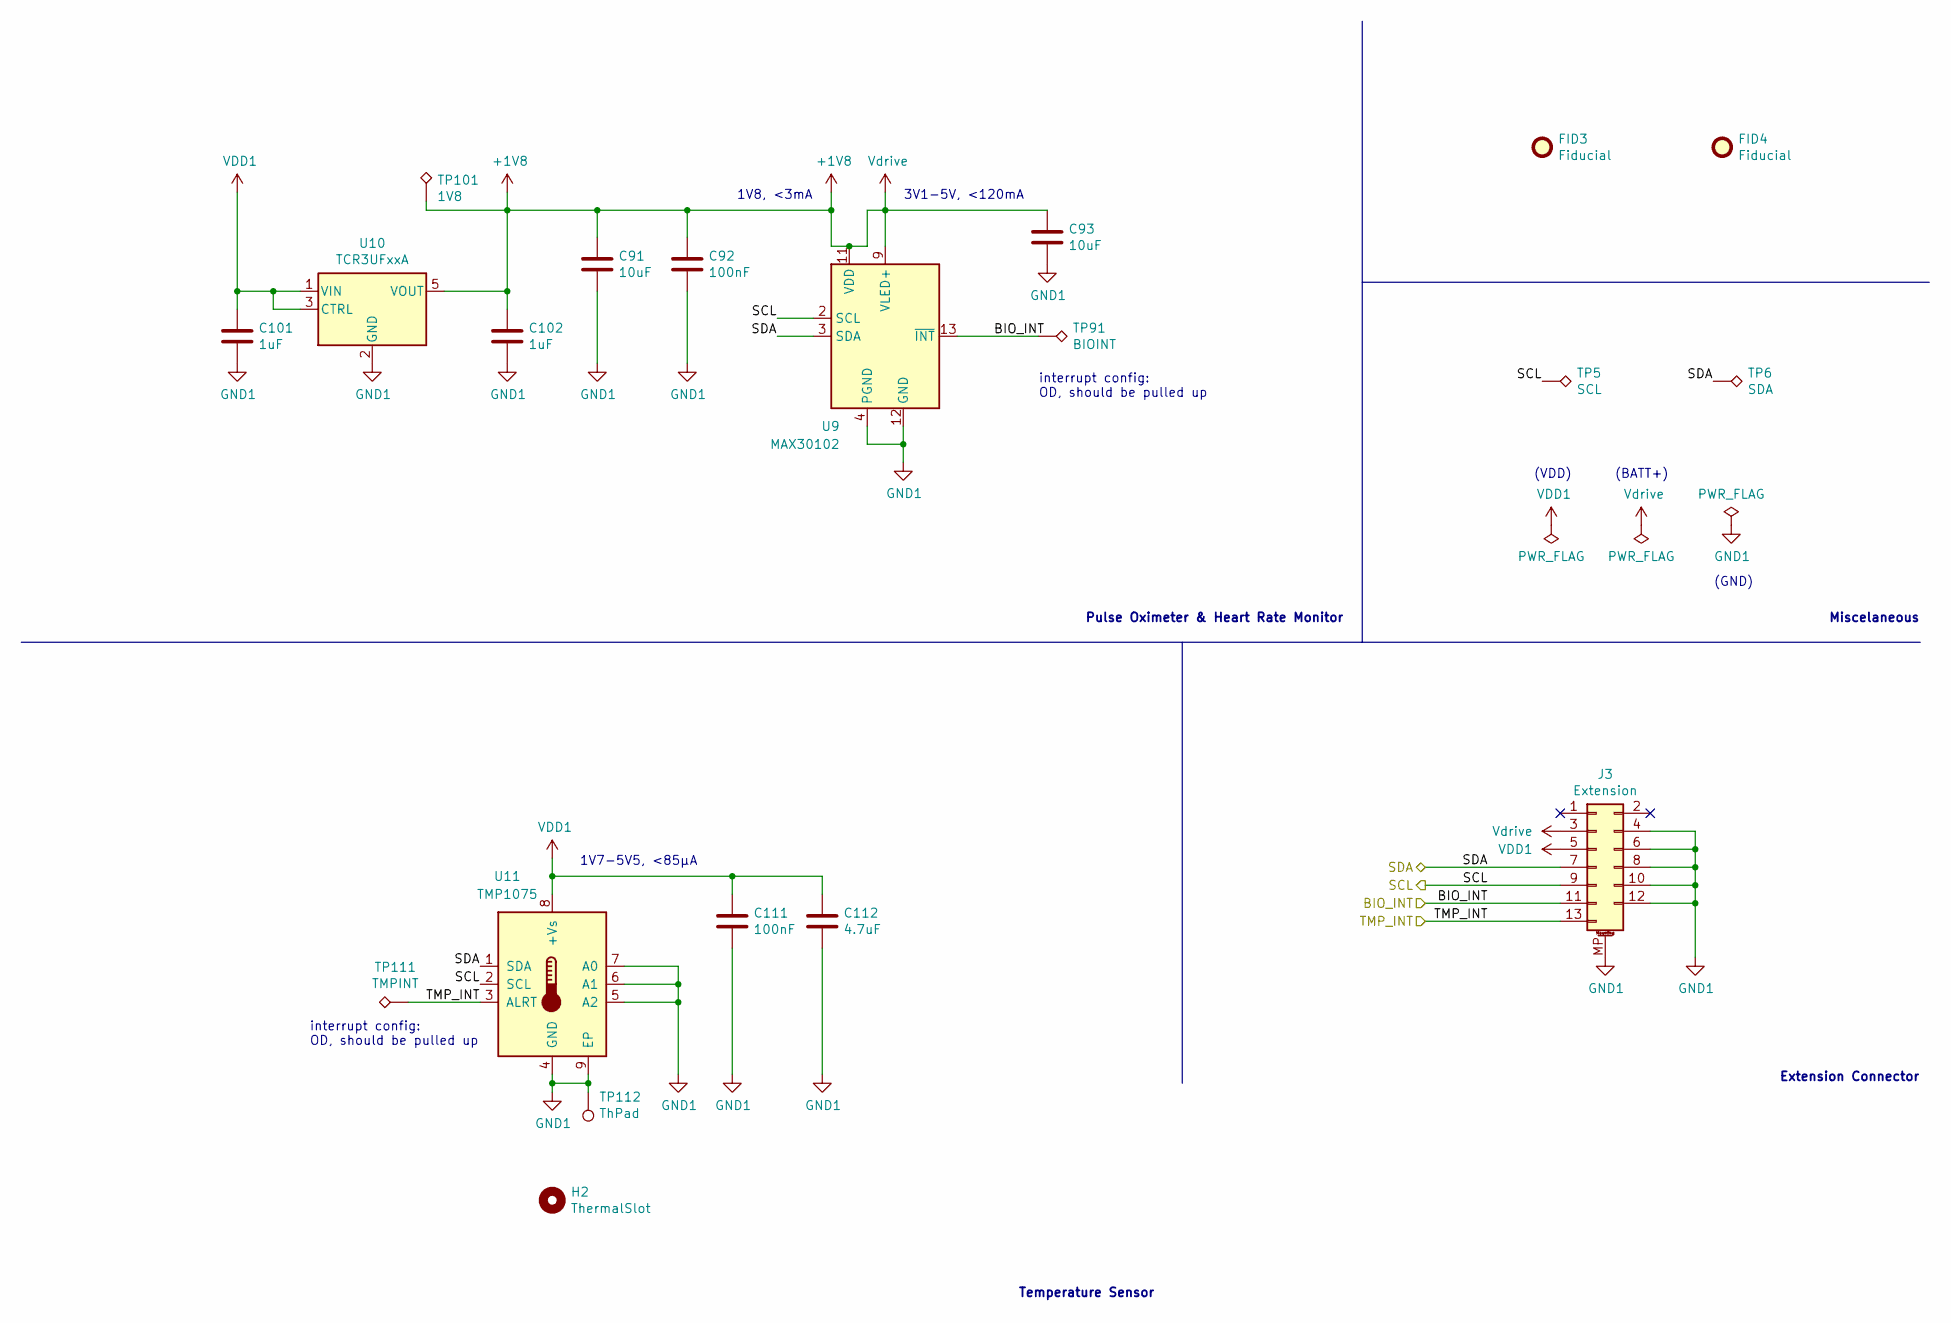
[picture p14: schematic wearable-ext.kicad_sch, Herald Wearable Bio-Monitor Daughter Board]

Parts:
C91, C93: 10uF; C_0402_1005Metric; MPN GRM155R60J106ME15D
C92, C111: 100nF; C_0402_1005Metric; MPN GRM155R71E104KE14D
C101, C102: 1uF; C_0402_1005Metric; MPN GRM155R61C105KA12D
C112: 4.7uF; C_0402_1005Metric; MPN 0402YD475MAT2A
FID3, FID4: Fiducial; Fiducial_0.75mm_Mask1.5mm
H2: ThermalSlot; MillSlot_8.0x1.0mm
J3: Extension; TE_1-2328724-3_2Rows_13Pins_P0.3mm_Horizontal; MPN 1-2328724-3
TP5: SCL; TestPoint_Pad_D1.0mm
TP6: SDA; TestPoint_Pad_D1.0mm
TP91: BIOINT; TestPoint_Pad_D1.0mm
TP101: 1V8; TestPoint_Pad_D1.0mm
TP111: TMPINT; TestPoint_Pad_D1.0mm
TP112: ThPad; TestPoint_Pad_D4.0mm
U9: MAX30102; Maxim_OLGA-14_3.3x5.6mm_P0.8mm; MPN MAX30102EFD+T
U10: TCR3UFxxA; SOT-23-5; MPN TCR3UF18A
U11: TMP1075; WSON-8-1EP_2x2mm_P0.5mm_EP0.9x1.6mm; MPN TMP1075DSGT

Connections:
+1V8: C91.1, C92.1, C93.1, C102.1, J3.3, TP101.1, U9.9 (VLED+), U9.10 (VLED+), U9.11 (VDD), U10.5 (VOUT); also elsewhere on the board
/Core Board/EXT_INT1: J3.11, TP91.1, U9.13 (~INT); also elsewhere on the board
/Core Board/EXT_INT2: J3.13, TP111.1, U11.3 (ALRT); also elsewhere on the board
/Core Board/SCL: J3.9, TP5.1, U9.2 (SCL), U11.2 (SCL); also elsewhere on the board
/Core Board/SDA: J3.7, TP6.1, U9.3 (SDA), U11.1 (SDA); also elsewhere on the board
GND1: C91.2, C92.2, C93.2, C101.2, C102.2, C111.1, C112.1, J3.4, J3.6, J3.8, J3.10, J3.12, J3.MP (MountPin), TP112.1, U9.4 (PGND), U9.12 (GND), U10.2 (GND), U11.4 (GND), U11.5 (A2), U11.6 (A1), U11.7 (A0), U11.9 (EP); also elsewhere on the board
VDD1: C101.1, C111.2, C112.2, J3.5, U10.1 (VIN), U10.3 (CTRL), U11.8 (+Vs); also elsewhere on the board

Notes on the sheet:
Miscelaneous
interrupt config: OD, should be pulled up
1V8, <3mA
3V1-5V, <120mA
Pulse Oximeter & Heart Rate Monitor
Temperature Sensor
1V7-5V5, <85µA
(GND)
(BATT+)
Extension Connector
(VDD)
