adamfowleruk/herald-hardware/wearable/pcb/wearable.kicad_pcb

## KiCad design wearable/pcb/wearable.kicad_pcb (continued)

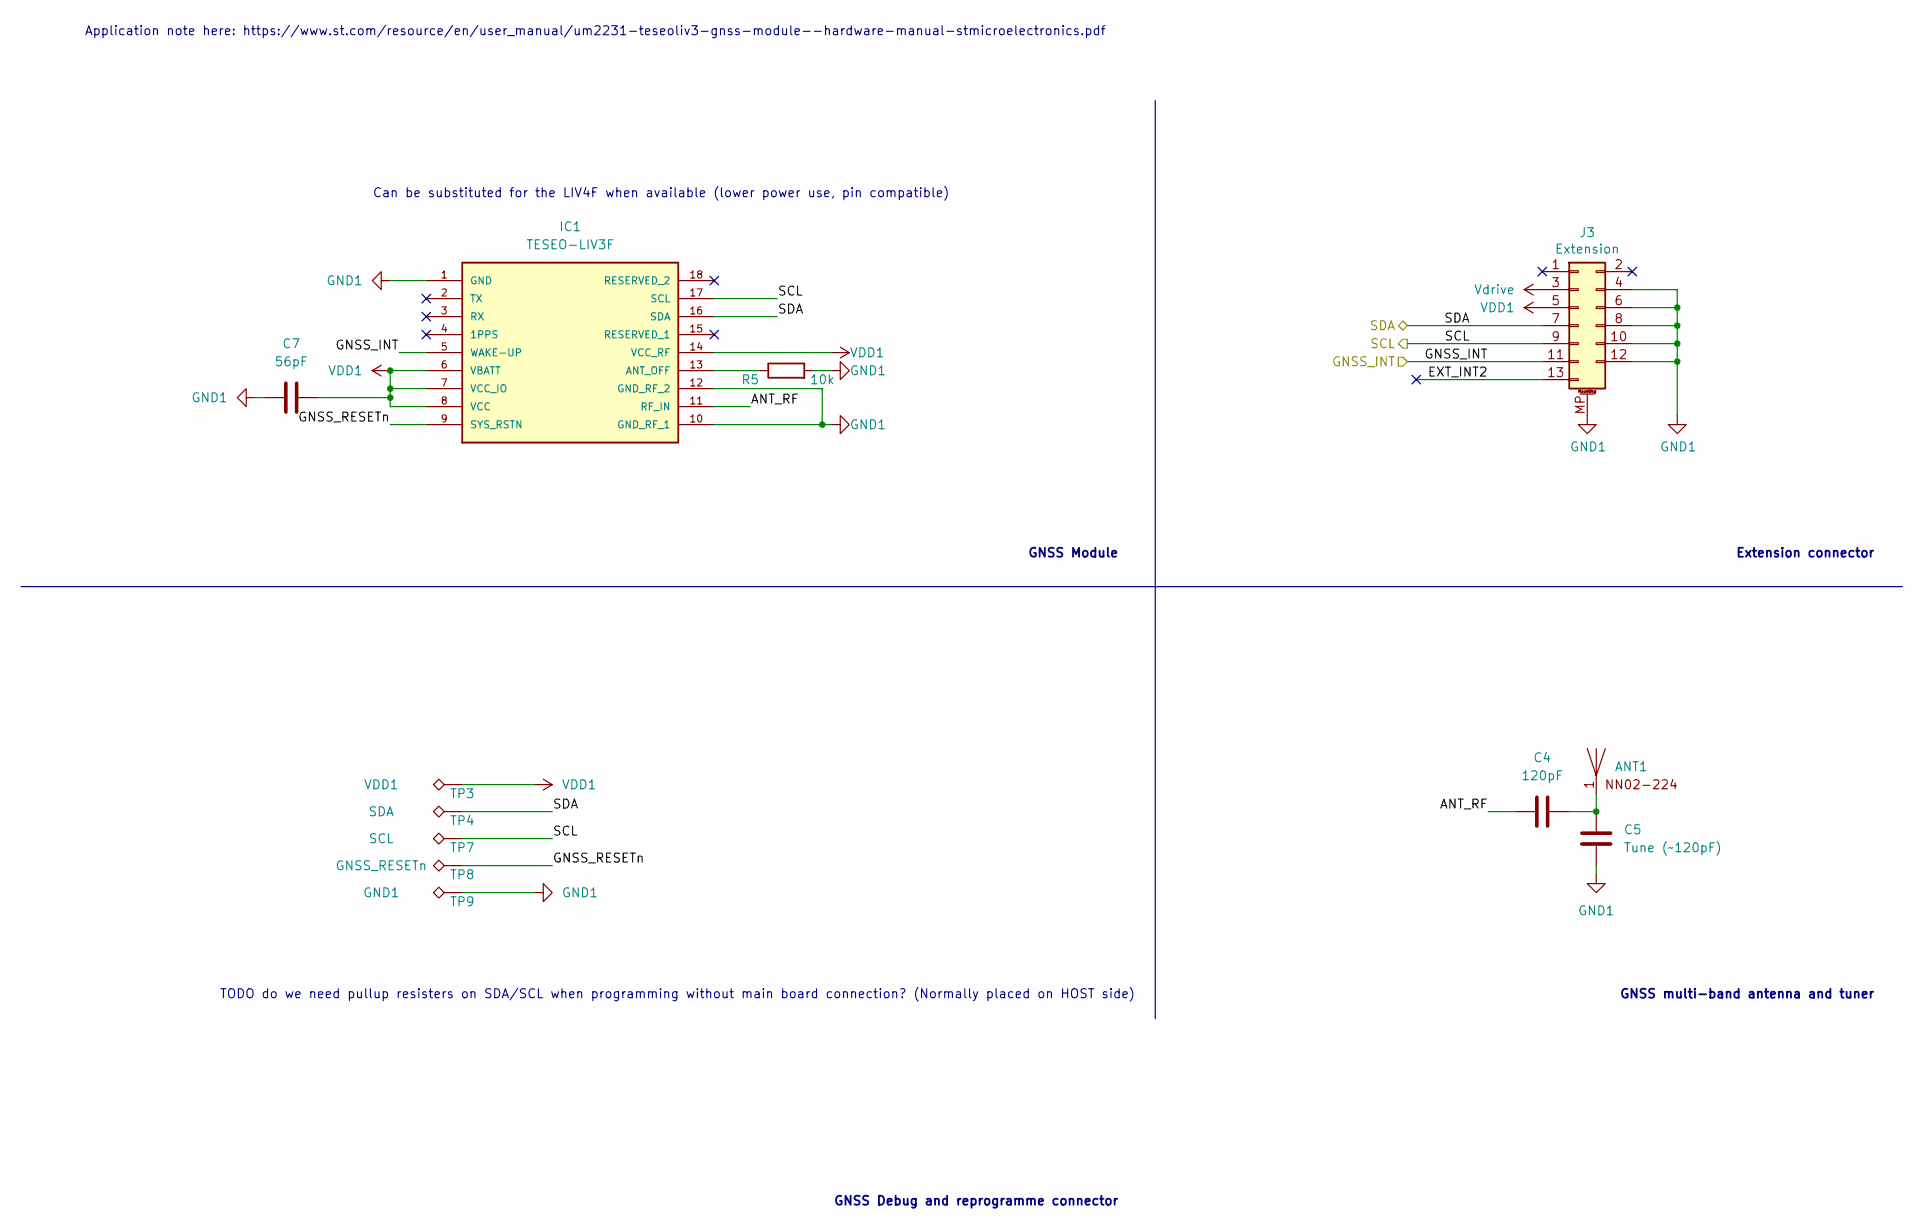
[picture p15: schematic wearable_gnss.kicad_sch, Herald Wearable GNSS Daughter Board]

Parts:
ANT1: NN02-224
C4: 120pF; C_0402_1005Metric
C5: Tune (~120pF); C_0402_1005Metric
C7: 56pF; C_0402_1005Metric
IC1: TESEO-LIV3F; SON110P970X1010X230-18N; MOUSER_PART_NUMBER 511-TESEO-LIV3F
J3: Extension; TE_1-2328724-3_2Rows_13Pins_P0.3mm_Horizontal; MPN 1-2328724-3
R5: 10k; R_0402_1005Metric
TP3: VDD1; TestPoint_Pad_D1.0mm
TP4: SDA; TestPoint_Pad_D1.0mm
TP7: SCL; TestPoint_Pad_D1.0mm
TP8: GNSS_RESETn; TestPoint_Pad_D1.0mm
TP9: GND1; TestPoint_Pad_D1.0mm

Connections:
+1V8: J3.3; also elsewhere on the board
/Core Board/EXT_INT1: IC1.5 (WAKE-UP), J3.11; also elsewhere on the board
/Core Board/EXT_INT2: J3.13; also elsewhere on the board
/Core Board/SCL: IC1.17 (SCL), J3.9, TP7.1; also elsewhere on the board
/Core Board/SDA: IC1.16 (SDA), J3.7, TP4.1; also elsewhere on the board
/GNSS Board/ANT_RF: C4.1, IC1.11 (RF_IN)
/GNSS Board/GNSS_RESETn: IC1.9 (SYS_RSTN), TP8.1
GND1: C5.2, C7.2, IC1.1 (GND), IC1.10 (GND_RF_1), IC1.12 (GND_RF_2), J3.4, J3.6, J3.8, J3.10, J3.12, J3.MP (MountPin), R5.2, TP9.1; also elsewhere on the board
unnamed: ANT1.1, C4.2, C5.1
unnamed: IC1.13 (ANT_OFF), R5.1
VDD1: C7.1, IC1.6 (VBATT), IC1.7 (VCC_IO), IC1.8 (VCC), IC1.14 (VCC_RF), J3.5, TP3.1; also elsewhere on the board

Notes on the sheet:
Application note here: https://www.st.com/resource/en/user_manual/um2231-teseoliv3-gnss-module--hardware-manual-stmicroelectronics.pdf
GNSS Debug and reprogramme connector
Can be substituted for the LIV4F when available (lower power use, pin compatible)
Extension connector
GNSS Module
GNSS multi-band antenna and tuner
TODO do we need pullup resisters on SDA/SCL when programming without main board connection? (Normally placed on HOST side)

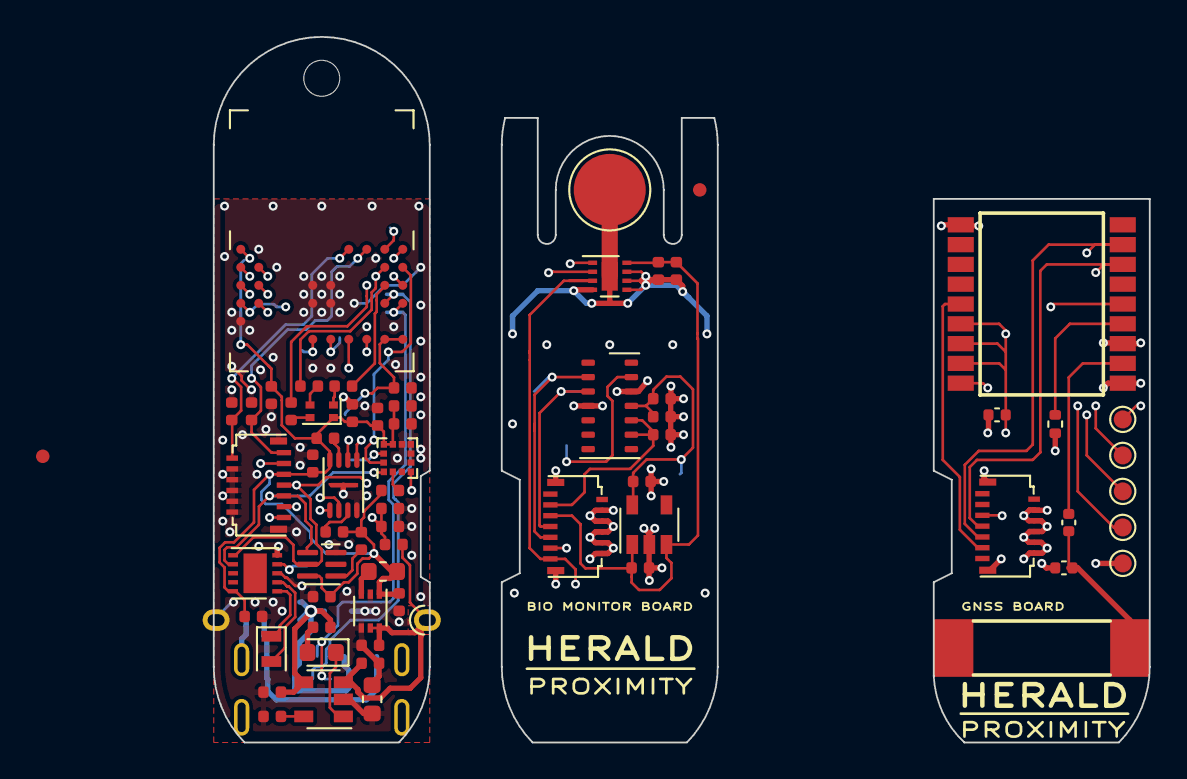
[picture p16: board wearable.kicad_pcb from above]

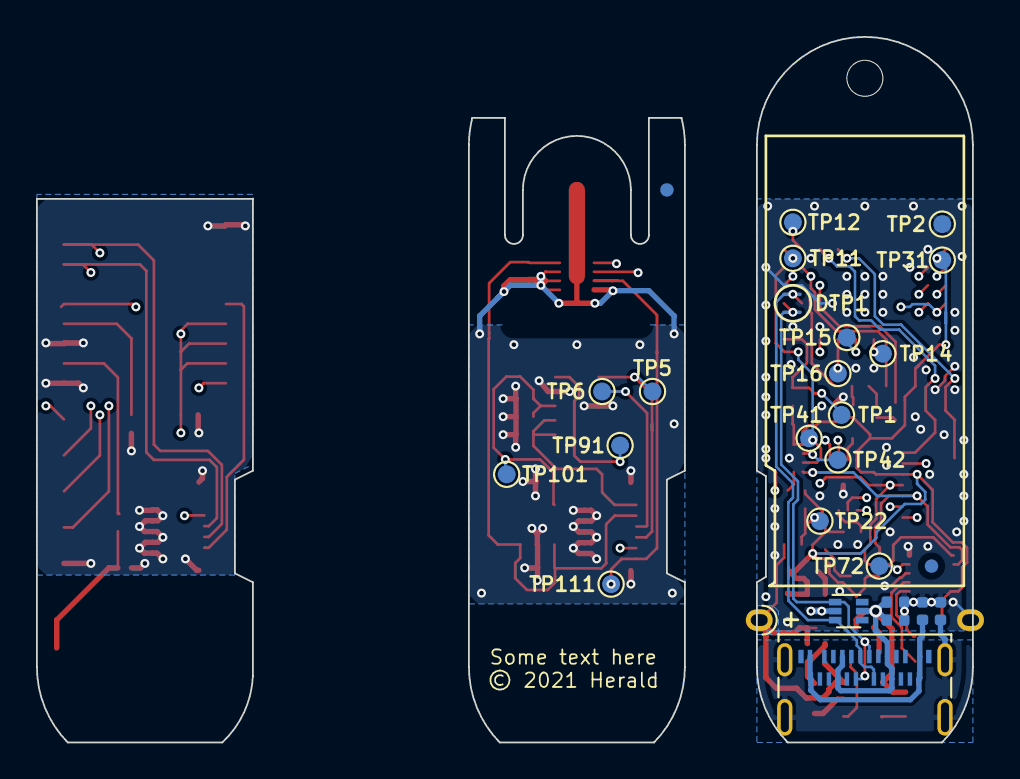
[picture p17: board wearable.kicad_pcb from below]

Board: 4 copper layers, 52.0 x 39.2 mm, 94 parts (26 on the bottom side), 47 nets.

Other parts of the board:
J4: Extension; TE_1-2328724-3_2Rows_13Pins_P0.3mm_Horizontal

Their connections:
+1V8: J4.3; also elsewhere on the board
/Core Board/EXT_INT1: J4.11; also elsewhere on the board
/Core Board/SCL: J4.9; also elsewhere on the board
/Core Board/SDA: J4.7; also elsewhere on the board
GND1: J4.4, J4.6, J4.8, J4.10, J4.12, J4.MP (MountPin); also elsewhere on the board
VDD1: J4.5; also elsewhere on the board
