adamfowleruk/herald-hardware/(commit log)

2023-07-16 Part of #16. Added Herald Wearable GNSS Daughter Board
    Also upgraded files to KiCAD 6+ (7.0.6) files
    Some missing elements still
    [wearable-core.kicad_sch, wearable-ext.kicad_sch, wearable.kicad_sch, wearable_gnss.kicad_sch]
2023-07-16 Part of #16. Added GNSS PCB layout
    Also added custom footprint for NN02-224 chip antenna.
    [wearable-core.kicad_sch, wearable.kicad_pcb, wearable_gnss.kicad_sch]
2023-07-16 Part of #16. Corrected antenna placement
    Ensured minimum 2.5mm ground plane clearance
    Added all component 3D models
    [wearable.kicad_pcb]
2023-09-29 Initial V2 wearable design work.
    [compute-fanstel-bc833m-nrf52833.kicad_sch, connector.kicad_sch, extension-bio-v1.kicad_sch, extension-display-v1.kicad_sch, extension-position-v1.kicad_sch, panel-button-v1.kicad_sch, panel-light-v1.kicad_sch, wearable-v2.kicad_pcb]
2023-10-08 Additional V2 wearable design work
    [wearable-v2.kicad_pcb]
2023-10-10 Updated components and PCB layout
    [compute-fanstel-bc833m-nrf52833.kicad_sch, connector.kicad_sch, extension-position-v1.kicad_sch, wearable-v2.kicad_pcb, wearable-v2.kicad_sch]
2023-10-15 Further V2 routing
    [compute-fanstel-bc833m-nrf52833.kicad_sch, connector.kicad_sch, extension-bio-v1.kicad_sch, extension-display-v1.kicad_sch, extension-position-v1.kicad_sch, panel-button-v1.kicad_sch, panel-light-v1.kicad_sch, wearable-v2.kicad_pcb]
2023-10-17 Replaced unavailable I2C chip
    [connector.kicad_sch, wearable-v2.kicad_pcb]
2023-10-17 Standard connector almost complete
    Added JLCPCB manufacturer settings to PCB
    Ensured all components are available and Tape and Reel with smallest footprint available
    [connector.kicad_sch, wearable-v2.kicad_pcb]
2023-10-17 Completed individual board layouts
    [wearable-v2.kicad_pcb]
2023-10-18 Laid out all boards together
    Added missing models for oscillator, push button, daylight sensor
    [wearable-v2.kicad_pcb]
2023-10-21 Added front connectors on main board
    [compute-fanstel-bc833m-nrf52833.kicad_sch, connector.kicad_sch, extension-bio-v1.kicad_sch, extension-display-v1.kicad_sch, extension-position-v1.kicad_sch, panel-button-v1.kicad_sch, panel-light-v1.kicad_sch, wearable-v2.kicad_pcb]
2023-10-21 Added plug connector and routed compute and positioning boards
    [wearable-v2.kicad_pcb]
2023-10-22 All board connectors routed
    Connector positions confirmed
    Extension board dimensions confirmed to not clash
    [connector.kicad_sch, wearable-v2.kicad_pcb]
2023-10-22 Corrected 1V8 routing to bio board
    [connector.kicad_sch, extension-bio-v1.kicad_sch, panel-light-v1.kicad_sch, wearable-v2.csv, wearable-v2.kicad_pcb]
2023-10-23 Set wider PCB GND tracks and vias
    [compute-fanstel-bc833m-nrf52833.kicad_sch, connector.kicad_sch, extension-bio-v1.kicad_sch, extension-position-v1.kicad_sch, wearable-v2.kicad_pcb]
2023-10-28 First look feedback board
    [extension-display-v1.kicad_sch]
2023-10-29 Added MPN and footprints to display components
    [extension-display-v1.kicad_sch]
2023-10-29 Display board physical layout improvements
    [extension-display-v1.kicad_sch, wearable-v2.kicad_pcb]
2023-10-29 Confirmed display board connectors
    [extension-display-v1.kicad_sch, wearable-v2.kicad_pcb]
2023-10-29 Upgraded flash and corrected XIF placement
    [compute-fanstel-bc833m-nrf52833.kicad_sch, extension-display-v1.kicad_sch, wearable-v2.kicad_pcb]
2023-11-01 Updated LRA, BOM. Added first 3D model
    [eHealthMakersKit.FCStd, extension-display-v1.kicad_sch, wearable-v2.csv, wearable-v2.kicad_pcb]
2023-11-03 Added I2C and I3C notes and additional resistors
    [compute-fanstel-bc833m-nrf52833.kicad_sch, connector.kicad_sch, extension-bio-v1.kicad_sch, extension-display-v1.kicad_sch, extension-position-v1.kicad_sch, panel-button-v1.kicad_sch, panel-light-v1.kicad_sch, wearable-v2.kicad_sch]
2023-11-05 Split main boards out into their own KiCAD files
    [compute-fanstel-bc833m-nrf52833.kicad_sch, connector-standard.kicad_sch, extension-bio-v1.kicad_sch, extension-display-v1.kicad_sch, extension-position-v1.kicad_sch, pcb-compute-nrf52833-bc833m.kicad_pcb, pcb-compute-nrf52833-bc833m.kicad_sch, pcb-expansion-bio.kicad_pcb]
2023-11-06 Refactoring PCB files
    Moved major boards into their own files.
    Corrected design elements for PCBWay manufacture.
    [compute-fanstel-bc833m-nrf52833.kicad_sch, connector-standard.kicad_sch, extension-display-v1.kicad_sch, pcb-adapter-armswd.kicad_pcb, pcb-adapter-armswd.kicad_sch, pcb-adapter-ftdi.kicad_pcb, pcb-adapter-ftdi.kicad_sch, pcb-compute-nrf52833-bc833m.kicad_pcb]
2023-11-09 Added accelerometer to compute module
    Enable low power movement interrupt modes with just the compute module.
    [compute-fanstel-bc833m-nrf52833.kicad_sch, pcb-compute-nrf52833-bc833m.kicad_pcb]
2023-11-11 Reworked boards for JLCPCB manufacture
    Slightly larger Vias.
    Added debug pin holes for Beta testing.
    [connector-standard.kicad_sch, extension-display-v1.kicad_sch, extension-position-v1.kicad_sch, pcb-adapter-armswd.kicad_pcb, pcb-adapter-ftdi.kicad_pcb, pcb-compute-nrf52833-bc833m.kicad_pcb, pcb-expansion-feedback.kicad_pcb, pcb-expansion-positioning.kicad_pcb]
2023-11-13 Added Antenna panel and Micro connector boards
    Micro connector uses the nPM1300 PMIC from Nordic Semi.
    [compute-fanstel-bc833m-nrf52833.kicad_sch, connector-micro.kicad_sch, extension-position-v1.kicad_sch, pcb-connector-micro.kicad_pcb, pcb-connector-micro.kicad_sch, pcb-expansion-positioning.kicad_pcb, pcb-panel-antnn02.kicad_pcb, pcb-panel-antnn02.kicad_sch]
