adamfowleruk/herald-hardware/(notices)

Notices in the files:
wearable-v2/pcb/panel-button-v1.kicad_sch:
Copyright 2021-2023 All Rights Reserved
Licensed under CERN OHL-P-V2
wearable-v2/pcb-adapter-ftdi/pcb-adapter-ftdi.kicad_pcb:
License: CERN-OHL-P-2
wearable/pcb/wearable_gnss.kicad_sch:
© 2021-2023 Herald Project Contributors
Licensed under CERN-OHL-P version 2
wearable-v2/pcb-panel-antnn02/pcb-panel-antnn02.kicad_pcb:
CERN-OHL-P-2
wearable-v2/pcb/wearable-v2.kicad_pcb:
Copyright 2020-2023
Licensed under CERN OHL-V2-P
wearable/pcb/wearable.kicad_pcb:
© 2021 Herald Project Contributors
© 2021 Herald
